baldengineer/State-Mode-Logic-Analyzer/images/state mode logic analyzer rev1 render.jpg

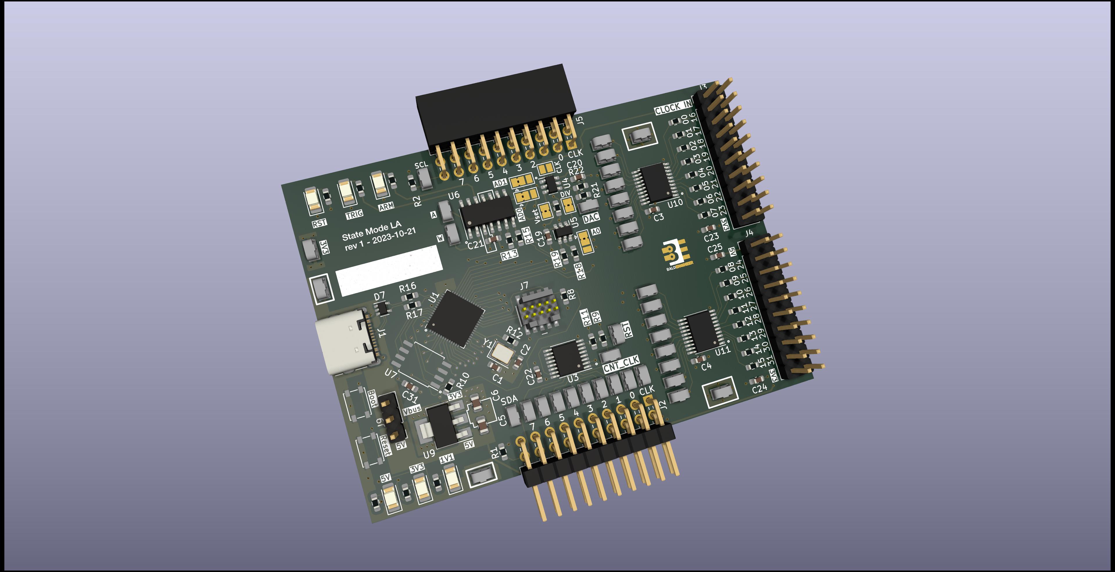
images/state mode logic analyzer rev1 render.jpg
