baldengineer/State-Mode-Logic-Analyzer/firmware/pico/README.md

This is some rough code to test on a Pi Pico. 

Eventually this will move to its own project, so don't be surprised if this doesn't build. 

:)
