baldengineer/State-Mode-Logic-Analyzer/kicad/rp2350/state mode logic analyzer rp2350.kicad_pcb

## KiCad design kicad/rp2350/state mode logic analyzer rp2350.kicad_pcb (2024-08-23)

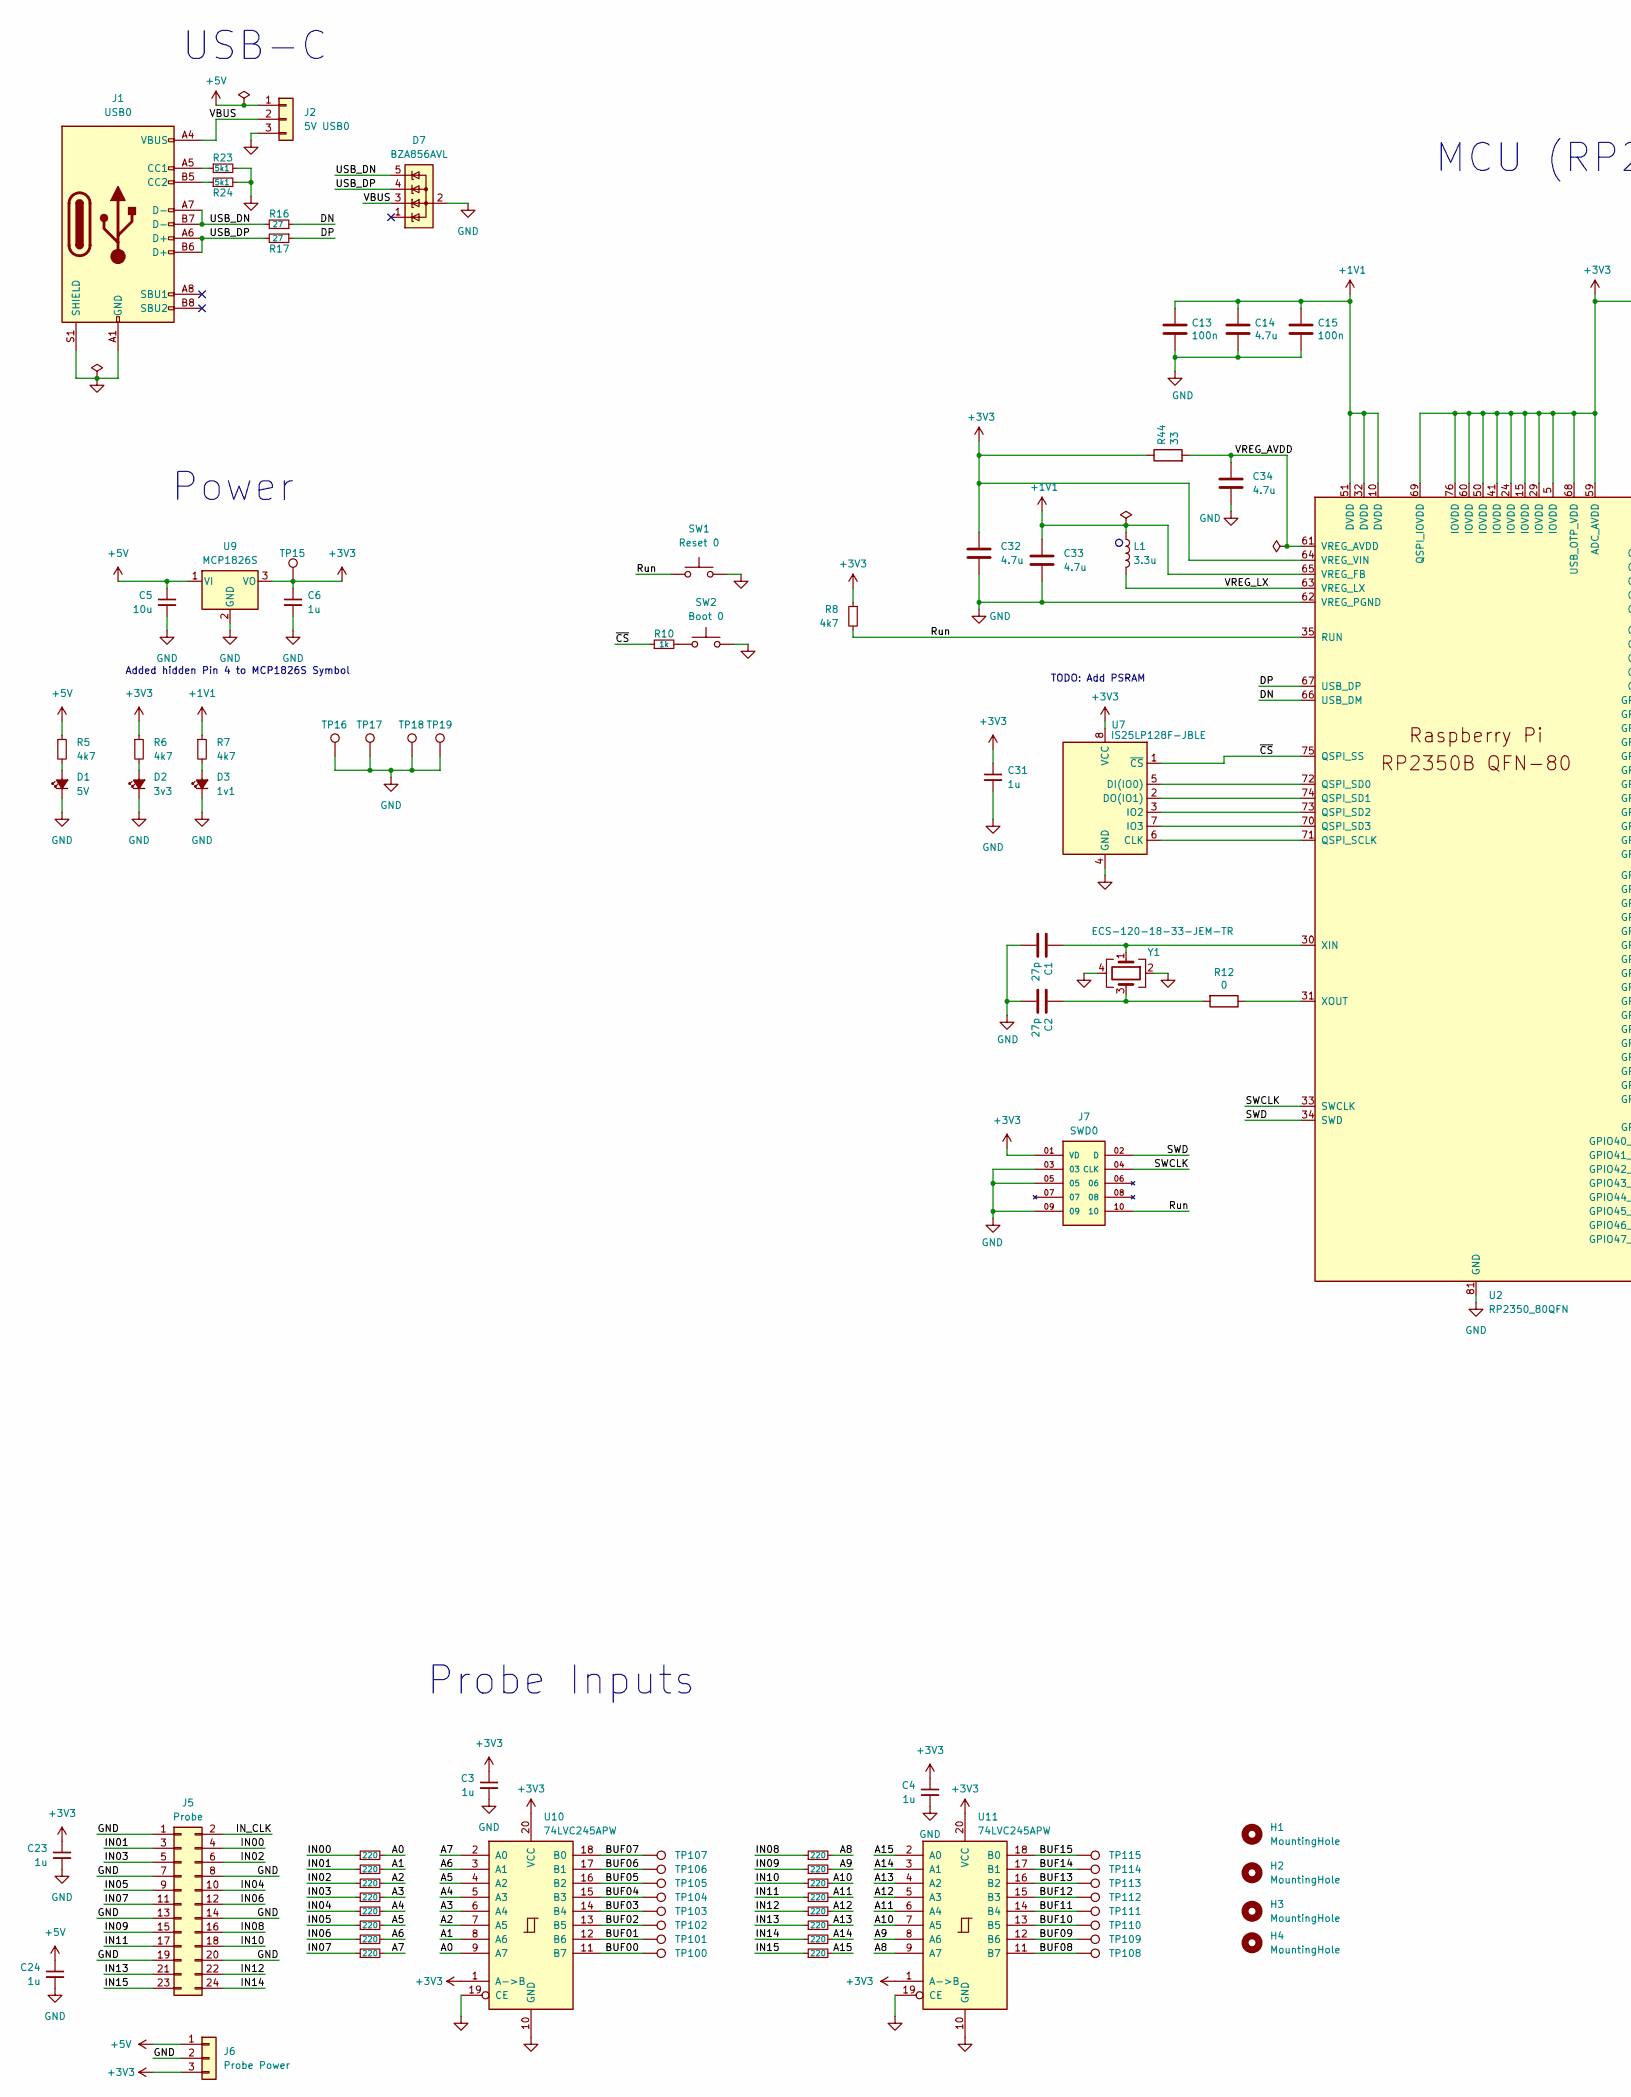
[picture p3: schematic state mode logic analyzer rp2350.kicad_sch, State Mode Logic Analyzer, part in row 1, column 1]

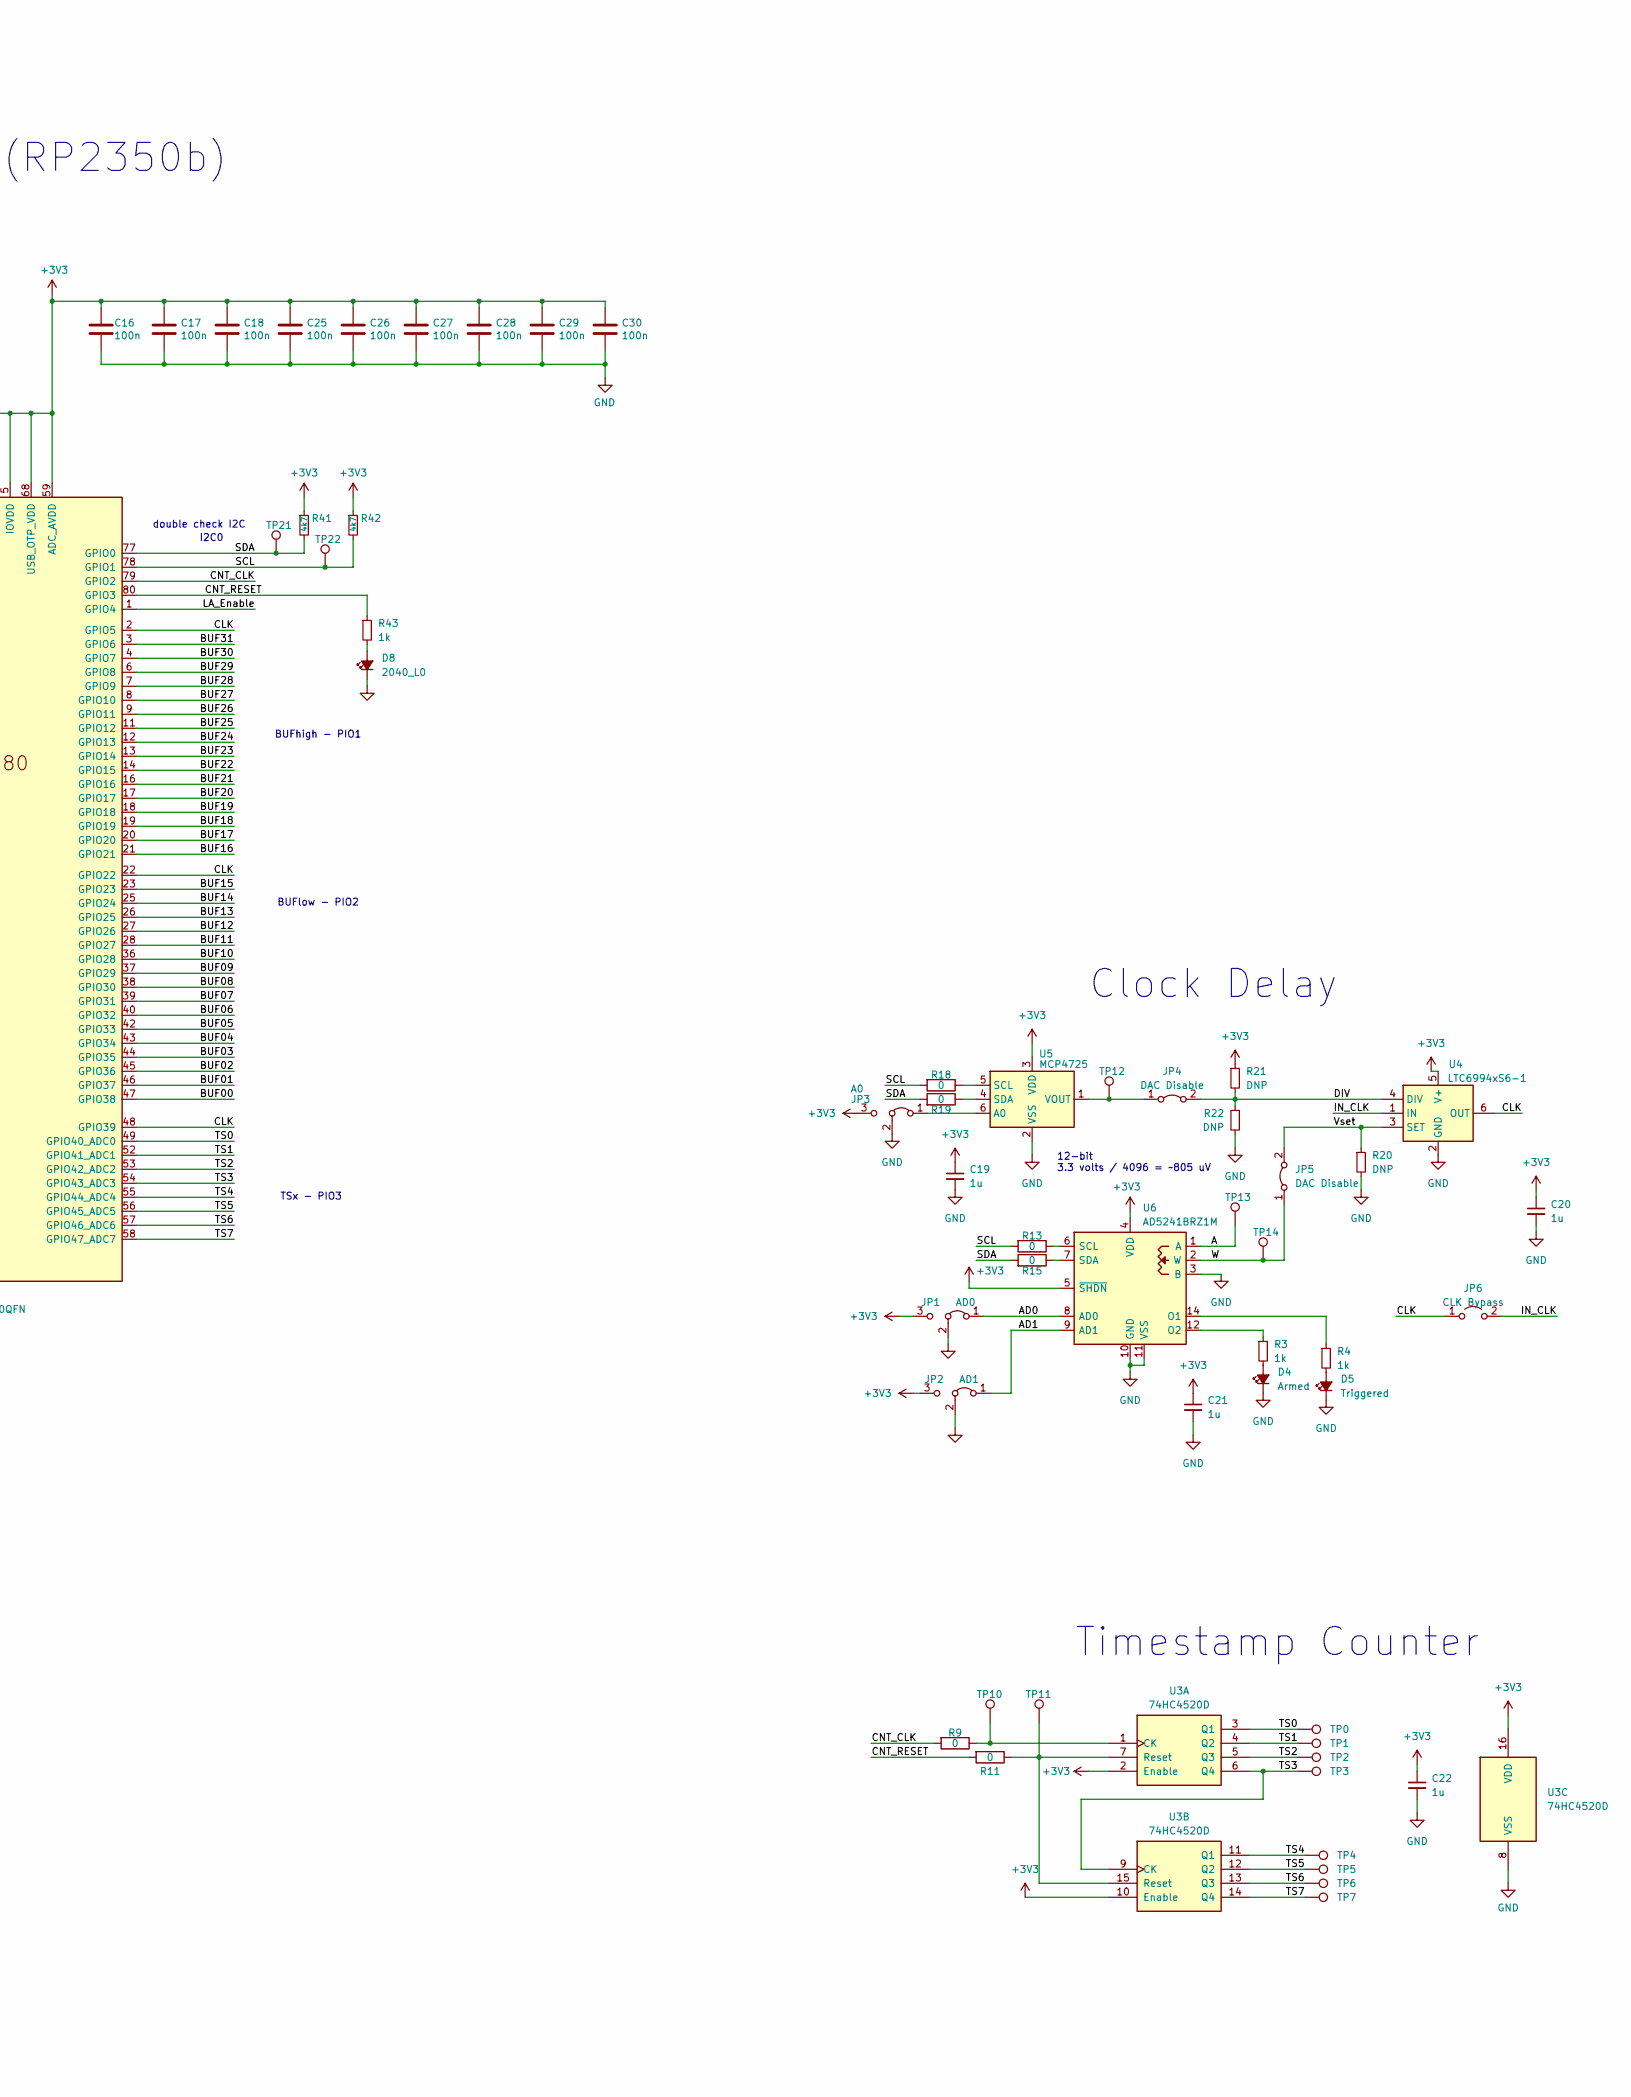
[picture p4: schematic state mode logic analyzer rp2350.kicad_sch, State Mode Logic Analyzer, part in row 1, column 2]

Parts:
C1, C2: 27p; C_0603_1608Metric
C3, C4, C19, C20, C21, C22, C23, C24, C31: 1u; C_0603_1608Metric_Pad1.08x0.95mm_HandSolder
C5: 10u; C_0805_2012Metric
C6: 1u; C_0805_2012Metric
C13, C15, C16, C17, C18, C25, C26, C27, C28, C29, C30: 100n; C_0402_1005Metric
C14, C34: 4.7u; C_0402_1005Metric
C32, C33: 4.7u; C_0402_1005Metric_small_pads
D1: 5V; LED_1206_3216Metric_Pad1.42x1.75mm_HandSolder
D2: 3v3; LED_1206_3216Metric_Pad1.42x1.75mm_HandSolder
D3: 1v1; LED_1206_3216Metric_Pad1.42x1.75mm_HandSolder
D4: Armed; LED_1206_3216Metric_Pad1.42x1.75mm_HandSolder
D5: Triggered; LED_1206_3216Metric_Pad1.42x1.75mm_HandSolder
D7: BZA856AVL; SOT-353_SC-70-5
D8: 2040_L0; LED_1206_3216Metric_Pad1.42x1.75mm_HandSolder
H1, H2, H3, H4: MountingHole; MountingHole_2.7mm
J1: USB0; USB_C_Receptacle_GCT_USB4105-xx-A_16P_TopMnt_Horizontal
J2: 5V USB0; PinHeader_1x03_P2.54mm_Vertical
J5: Probe; PinHeader_2x12_P2.54mm_Vertical
J6: Probe Power; PinHeader_1x03_P2.54mm_Vertical
J7: SWD0; SAMTEC_FTSH-105-XX-X-DV; PARTREV H
JP1: AD0; SolderJumper-3_P1.3mm_Bridged2Bar12_Pad1.0x1.5mm
JP2: AD1; SolderJumper-3_P1.3mm_Bridged2Bar12_Pad1.0x1.5mm
JP3: A0; SolderJumper-3_P1.3mm_Bridged2Bar12_Pad1.0x1.5mm
JP4, JP5: DAC Disable; SolderJumper-2_P1.3mm_Bridged2Bar_Pad1.0x1.5mm
JP6: CLK Bypass; SolderJumper-2_P1.3mm_Open_Pad1.0x1.5mm
L1: 3.3u; L_pol_2016
R3, R4, R10, R43: 1k; R_0603_1608Metric_Pad0.98x0.95mm_HandSolder
R5, R6, R7, R8, R41, R42: 4k7; R_0603_1608Metric_Pad0.98x0.95mm_HandSolder
R9, R11, R12, R13, R15, R18, R19: 0; R_0603_1608Metric_Pad0.98x0.95mm_HandSolder
R16, R17: 27; R_0603_1608Metric_Pad0.98x0.95mm_HandSolder
R20, R21, R22: DNP; R_0603_1608Metric_Pad0.98x0.95mm_HandSolder
R23, R24: 5k1; R_0603_1608Metric_Pad0.98x0.95mm_HandSolder
R25, R26, R27, R28, R29, R30, R31, R32, R33, R34, R35, R36, R37, R38, R39, R40: 220; R_0603_1608Metric
R44: 33; R_0402_1005Metric
SW1: Reset 0; SW_SPST_PTS810
SW2: Boot 0; SW_SPST_PTS810
TP0, TP1, TP2, TP3, TP4, TP5, TP6, TP7, TP10, TP11, TP12, TP13, TP14, TP15, TP16, TP17, TP18, TP19, TP21, TP22, TP100, TP101, TP102, TP103, TP104, TP105, TP106, TP107, TP108, TP109, TP110, TP111, TP112, TP113, TP114, TP115: TestPoint_Harwin; Harwin-S1751-46-Test-Point
U2: RP2350_80QFN; RP2350-QFN-80-1EP_10x10_P0.4mm_EP3.4x3.4mm_ThermalVias
U3: 74HC4520D; TSSOP-16_4.4x5mm_P0.65mm
U4: LTC6994xS6-1; TSOT-23-6
U5: MCP4725; SOT-23-6
U6: AD5241BRZ1M; SOIC-16_3.9x9.9mm_P1.27mm
U7: IS25LP128F-JBLE; SOIC-8_5.23x5.23mm_P1.27mm
U9: MCP1826S; SOT-223
U10, U11: 74LVC245APW; TSSOP-20_4.4x6.5mm_P0.65mm
Y1: ECS-120-18-33-JEM-TR; Crystal_SMD_3225-4Pin_3.2x2.5mm

Connections:
+1V1: C13.1, C14.1, C15.1, C33.1, L1.1, R7.1, U2.10 (DVDD), U2.32 (DVDD), U2.51 (DVDD), U2.65 (VREG_FB)
+3V3: C3.1, C4.1, C6.1, C16.1, C17.1, C18.1, C19.1, C20.1, C21.1, C22.1, C23.1, C25.1, C26.1, C27.1, C28.1, C29.1, C30.1, C31.1, C32.1, J6.3, J7.01 (VD), JP1.3 (B), JP2.3 (B), JP3.3 (B), R6.1, R8.1, R21.1, R41.1, R42.1, R44.1, TP15.1, U2.5 (IOVDD), U2.15 (IOVDD), U2.24 (IOVDD), U2.29 (IOVDD), U2.41 (IOVDD), U2.50 (IOVDD), U2.59 (ADC_AVDD), U2.60 (IOVDD), U2.64 (VREG_VIN), U2.68 (USB_OTP_VDD), U2.69 (QSPI_IOVDD), U2.76 (IOVDD), U3.2 (Enable), U3.10 (Enable), U3.16 (VDD), U4.5 (V+), U5.3 (VDD), U6.4 (VDD), U6.5 (~SHDN), U7.8 (VCC), U9.3 (VO), U10.1 (A->B), U10.20 (VCC), U11.1 (A->B), U11.20 (VCC)
+5V: C5.1, C24.1, J2.1, J6.1, R5.1, U9.1 (VI)
/A: TP13.1, U6.1 (A)
/A0: R25.2, U10.9 (A7)
/A1: R26.2, U10.8 (A6)
/A2: R27.2, U10.7 (A5)
/A3: R28.2, U10.6 (A4)
/A4: R29.2, U10.5 (A3)
/A5: R30.2, U10.4 (A2)
/A6: R31.2, U10.3 (A1)
/A7: R32.2, U10.2 (A0)
/A8: R33.2, U11.9 (A7)
/A9: R34.2, U11.8 (A6)
/A10: R35.2, U11.7 (A5)
/A11: R36.2, U11.6 (A4)
/A12: R37.2, U11.5 (A3)
/A13: R38.2, U11.4 (A2)
/A14: R39.2, U11.3 (A1)
/A15: R40.2, U11.2 (A0)
/AD0: JP1.1 (A), U6.8 (AD0)
/AD1: JP2.1 (A), U6.9 (AD1)
/BUF00: TP100.1, U2.47 (GPIO38), U10.11 (B7)
/BUF01: TP101.1, U2.46 (GPIO37), U10.12 (B6)
/BUF02: TP102.1, U2.45 (GPIO36), U10.13 (B5)
/BUF03: TP103.1, U2.44 (GPIO35), U10.14 (B4)
/BUF04: TP104.1, U2.43 (GPIO34), U10.15 (B3)
/BUF05: TP105.1, U2.42 (GPIO33), U10.16 (B2)
/BUF06: TP106.1, U2.40 (GPIO32), U10.17 (B1)
/BUF07: TP107.1, U2.39 (GPIO31), U10.18 (B0)
/BUF08: TP108.1, U2.38 (GPIO30), U11.11 (B7)
/BUF09: TP109.1, U2.37 (GPIO29), U11.12 (B6)
/BUF10: TP110.1, U2.36 (GPIO28), U11.13 (B5)
/BUF11: TP111.1, U2.28 (GPIO27), U11.14 (B4)
/BUF12: TP112.1, U2.27 (GPIO26), U11.15 (B3)
/BUF13: TP113.1, U2.26 (GPIO25), U11.16 (B2)
/BUF14: TP114.1, U2.25 (GPIO24), U11.17 (B1)
/BUF15: TP115.1, U2.23 (GPIO23), U11.18 (B0)
/BUF16: U2.21 (GPIO21)
/BUF17: U2.20 (GPIO20)
/BUF18: U2.19 (GPIO19)
/BUF19: U2.18 (GPIO18)
/BUF20: U2.17 (GPIO17)
/BUF21: U2.16 (GPIO16)
/BUF22: U2.14 (GPIO15)
/BUF23: U2.13 (GPIO14)
/BUF24: U2.12 (GPIO13)
/BUF25: U2.11 (GPIO12)
/BUF26: U2.9 (GPIO11)
/BUF27: U2.8 (GPIO10)
/BUF28: U2.7 (GPIO9)
/BUF29: U2.6 (GPIO8)
/BUF30: U2.4 (GPIO7)
/BUF31: U2.3 (GPIO6)
/CLK: JP6.1 (A), U2.2 (GPIO5), U2.22 (GPIO22), U2.48 (GPIO39), U4.6 (OUT)
/CNT_CLK: R9.2, U2.79 (GPIO2)
/CNT_RESET: R11.2, R43.1, U2.80 (GPIO3)
/DIV: JP4.2 (B), R21.2, R22.1, U4.4 (DIV)
/DN: R16.1, U2.66 (USB_DM)
/DP: R17.1, U2.67 (USB_DP)
/IN00: J5.4, R25.1
/IN01: J5.3, R26.1
/IN02: J5.6, R27.1
/IN03: J5.5, R28.1
/IN04: J5.10, R29.1
/IN05: J5.9, R30.1
/IN06: J5.12, R31.1
/IN07: J5.11, R32.1
/IN08: J5.16, R33.1
/IN09: J5.15, R34.1
/IN10: J5.18, R35.1
/IN11: J5.17, R36.1
/IN12: J5.22, R37.1
/IN13: J5.21, R38.1
/IN14: J5.24, R39.1
/IN15: J5.23, R40.1
/IN_CLK: J5.2, JP6.2 (B), U4.1 (IN)
/LA_Enable: U2.1 (GPIO4)
/Run: J7.10, R8.2, SW1.1, U2.35 (RUN)
/SCL: R13.2, R18.2, R42.2, TP22.1, U2.78 (GPIO1)
/SDA: R15.2, R19.2, R41.2, TP21.1, U2.77 (GPIO0)
/SWCLK: J7.04 (CLK), U2.33 (SWCLK)
/SWD: J7.02 (D), U2.34 (SWD)
/TS0: TP0.1, U2.49 (GPIO40_ADC0), U3.3 (Q1)
/TS1: TP1.1, U2.52 (GPIO41_ADC1), U3.4 (Q2)
/TS2: TP2.1, U2.53 (GPIO42_ADC2), U3.5 (Q3)
/TS3: TP3.1, U2.54 (GPIO43_ADC3), U3.6 (Q4), U3.9 (CK)
/TS4: TP4.1, U2.55 (GPIO44_ADC4), U3.11 (Q1)
/TS5: TP5.1, U2.56 (GPIO45_ADC5), U3.12 (Q2)
/TS6: TP6.1, U2.57 (GPIO46_ADC6), U3.13 (Q3)
/TS7: TP7.1, U2.58 (GPIO47_ADC7), U3.14 (Q4)
/USB_DN: D7.5 (K), J1.A7 (D-), J1.B7 (D-), R16.2
/USB_DP: D7.4 (K), J1.A6 (D+), J1.B6 (D+), R17.2
/VBUS: D7.3 (K), J1.A4 (VBUS), J1.A9 (VBUS), J1.B4 (VBUS), J1.B9 (VBUS), J2.2
/VREG_AVDD: C34.1, R44.2, U2.61 (VREG_AVDD)
/VREG_LX: L1.2, U2.63 (VREG_LX)
/Vset: JP5.2 (B), R20.1, U4.3 (SET)
/W: JP5.1 (A), TP14.1, U6.2 (W)
/~CS: R10.1, U2.75 (QSPI_SS), U7.1 (~CS)
GND: C1.2, C2.2, C3.2, C4.2, C5.2, C6.2, C13.2, C14.2, C15.2, C16.2, C17.2, C18.2, C19.2, C20.2, C21.2, C22.2, C23.2, C24.2, C25.2, C26.2, C27.2, C28.2, C29.2, C30.2, C31.2, C32.2, C33.2, C34.2, D1.1 (K), D2.1 (K), D3.1 (K), D4.1 (K), D5.1 (K), D7.2 (A), D8.1 (K), J1.A1 (GND), J1.A12 (GND), J1.B1 (GND), J1.B12 (GND), J1.S1 (SHIELD), J2.3, J5.1, J5.7, J5.8, J5.13, J5.14, J5.19, J5.20, J6.2, J7.03, J7.05, J7.09, JP1.2 (C), JP2.2 (C), JP3.2 (C), R20.2, R22.2, R23.2, R24.2, SW1.2, SW2.2, TP16.1, TP17.1, TP18.1, TP19.1, U2.62 (VREG_PGND), U2.81 (GND), U3.8 (VSS), U4.2 (GND), U5.2 (VSS), U6.3 (B), U6.10 (GND), U6.11 (VSS), U7.4 (GND), U9.2 (GND), U10.10 (GND), U10.19 (CE), U11.10 (GND), U11.19 (CE), Y1.2, Y1.4
unnamed: C2.1, R12.2, Y1.3
unnamed: D1.2 (A), R5.2
unnamed: D2.2 (A), R6.2
unnamed: D3.2 (A), R7.2
unnamed: D4.2 (A), R3.2
unnamed: D5.2 (A), R4.2
unnamed: D8.2 (A), R43.2
unnamed: J1.A5 (CC1), R23.1
unnamed: J1.B5 (CC2), R24.1
unnamed: JP3.1 (A), U5.6 (A0)
unnamed: JP4.1 (A), TP12.1, U5.1 (VOUT)
unnamed: R10.2, SW2.1
unnamed: U2.71 (QSPI_SCLK), U7.6 (CLK)
unnamed: U2.72 (QSPI_SD0), U7.5 (DI(IO0))
unnamed: U2.74 (QSPI_SD1), U7.2 (DO(IO1))
unnamed: U2.73 (QSPI_SD2), U7.3 (IO2)
unnamed: U2.70 (QSPI_SD3), U7.7 (IO3)
unnamed: C1.1, U2.30 (XIN), Y1.1
unnamed: R12.1, U2.31 (XOUT)
unnamed: R9.1, TP10.1, U3.1 (CK)
unnamed: R11.1, TP11.1, U3.7 (Reset), U3.15 (Reset)
unnamed: R18.1, U5.5 (SCL)
unnamed: R19.1, U5.4 (SDA)
unnamed: R4.1, U6.14 (O1)
unnamed: R3.1, U6.12 (O2)
unnamed: R13.1, U6.6 (SCL)
unnamed: R15.1, U6.7 (SDA)

Notes on the sheet:
BUFhigh - PIO1
Clock Delay
Timestamp Counter
Added hidden Pin 4 to MCP1826S Symbol
TODO: Add PSRAM
Power
BUFlow - PIO2
TSx - PIO3
USB-C
MCU (RP2350b)
12-bit 3.3 volts / 4096 = ~805 uV
Probe Inputs
I2C0
double check I2C

Board: 4 copper layers, 141 parts (2 on the bottom side), 110 nets, no tracks yet.

Other parts of the board:
svg2mod: G***; BE5v2
