baldengineer/State-Mode-Logic-Analyzer/firmware/pico/pico.c

#include <stdio.h>
#include "pico/stdlib.h"
#include "pico/binary_info.h"

#include "hardware/gpio.h"
#include "hardware/pio.h"
#include "hardware/dma.h"
#include "hardware/i2c.h"
#include "hardware/pwm.h"

#include "smla.pio.h"

#define CLK_IN 5
#define TS_CNTR_CLK 2
#define LED_PIN 3

void i2c_scan();

// PIO 1 of ?
PIO pio;
uint pio_offset;
uint pio_sm;
uint la_dma_chan=10;

// Buffer for data capture
#define SAMPLE_COUNT 4096
uint32_t cap_buf[SAMPLE_COUNT]; // 128 kilobytes, i think?

// shortcut for setting up output pins (there isn't a SDK call for this?)
void out_init(uint8_t pin, bool state) {
    gpio_init(pin);
    gpio_set_dir(pin, GPIO_OUT);
    gpio_put(pin, state);
}

// incoming data is only 24 bits wide, but I think
// I need to align things to a 32-bit boundry?
void fill_buffer(uint32_t *cap_buf) {
    for (uint16_t x=0; x<SAMPLE_COUNT; x++) {
        cap_buf[x] = 0xFFFF;
    }
}

// borrowed from mega's vga2040
void print_hex_buf(const uint32_t *buf, uint word_count, uint line_count) {
    printf("---[START]---\n");
    for (int x=0; x < (word_count * line_count); x++) {   // 
        if (x % 10 == 0)
            printf("\n");
        uint32_t current_word = buf[x];
        printf("%08x", current_word);
    }
    printf("\n---[END]---\n");

}

void print_capture_buf(const uint32_t *buf, uint word_count, uint offset) {
   // printf("Captured: Hex, Binary, RGBx[4 Words, right to left]\n");
    for (int x=0; x < word_count; x++) {
       // printf("%d:%08x, b%b\n", x, buf[x], buf[x]); // lol, %b works
       uint32_t current_buf = buf[x+(word_count*offset)];
        printf("%d: 0x%02x\n", x+(word_count*offset), current_buf); // lol, %b works

        // for (int j=0; j<8; j++) {
        //     uint offset = 4 * j;
        //     printf((current_buf & (0x1<<0+(offset))) ? "1" : "0");
        //     printf((current_buf & (0x1<<1+(offset))) ? "1" : "0");
        //     printf((current_buf & (0x1<<2+(offset))) ? "1" : "0");
        //     printf((current_buf & (0x1<<3+(offset))) ? "1" : "0");
        //     printf((j!=7) ? ", " : "");
        // } 
        // printf("\n");
    }
   // printf("\n");
}


void smla_pio_setup() {
    pio = pio0;
    pio_offset = pio_add_program(pio, &SMLA_program);

    pio_sm = pio_claim_unused_sm(pio, true);
    pio_sm_config c = SMLA_program_get_default_config(pio_offset);
    pio_sm_set_enabled(pio, pio_sm, false);

    pio_gpio_init(pio, CLK_IN);

    sm_config_set_in_pins(&c, 8);
    pio_sm_set_consecutive_pindirs(pio, pio_sm, 8, 8, GPIO_IN);
    sm_config_set_clkdiv(&c, 1); 

    // From C SDK PDF:
    // sm_config_set_in_shift sets the shift direction to rightward, enables autopush, and sets the autopush threshold to 32.
    // The state machine keeps an eye on the total amount of data shifted into the ISR, and on the in which reaches or
    // breaches a total shift count of 24 (or whatever number you have configured), the ISR contents, along with the new data
    // from the in. goes straight to the RX FIFO. The ISR is cleared to zero in the same operation.
    sm_config_set_in_shift(&c, false, true, 8); // i've setup 8 bits to make this boundry clean, i think
    //sm_config_set_fifo_join(&c, PIO_FIFO_JOIN_NONE); // PIO_FIFO_JOIN_NONE, _RX, _TX
    
    pio_sm_init(pio, pio_sm, pio_offset, &c);
}

void smla_pio_stop() {
    pio_sm_set_enabled(pio, pio_sm, false);
    pio_sm_clear_fifos(pio, pio_sm);  
}

void smla_pio_run() {
    pio_sm_set_enabled(pio, pio_sm, false);
    pio_sm_restart(pio, pio_sm);
    pio_sm_clear_fifos(pio, pio_sm);  


    // ------------------
   // la_dma_chan = 10;// dma_claim_unused_channel(false);
    dma_channel_config c = dma_channel_get_default_config(la_dma_chan);
    channel_config_set_read_increment(&c, false);
    channel_config_set_write_increment(&c, true);
	//channel_config_set_bswap(&c,true);
    channel_config_set_dreq(&c, pio_get_dreq(pio, pio_sm, false));

    dma_channel_configure(
        la_dma_chan,            // dma channel
        &c,                     // configuration
        cap_buf,                // Destination pointer
        &pio->rxf[pio_sm],      // Source pointer
        SAMPLE_COUNT,           // Number of transfers
        true                    // Start immediately
    );
    //------------------

    // will the real PIO reset, please stand up.
   //    
    pio_sm_exec(pio, pio_sm, pio_encode_jmp(SMLA_offset_start)); // why is this locking up the PIO now?
    pio_sm_set_enabled(pio, pio_sm, true);
    // Load our configraution, and jump to program start
    // pio_sm_init(pio, pio_sm, pio_offset, &c);

    // set the state machine running
    // pio_sm_set_enabled(pio, pio_sm, true);
}


void setup_pwm(uint16_t pwm_wrap, uint16_t pwm_level) {
    gpio_set_function(TS_CNTR_CLK, GPIO_FUNC_PWM);

    uint slice_num = pwm_gpio_to_slice_num(TS_CNTR_CLK);
    printf("GPIO %d has PWM slice %d", TS_CNTR_CLK, slice_num);
    pwm_set_wrap(slice_num, 2); // 0 to 4 inclusive
    pwm_config config = pwm_get_default_config();
    // Set divider, reduces counter clock to sysclock/this value
    //pwm_config_set_clkdiv(&config, 4.f);
    // Load the configuration into our PWM slice, and set it running.
    pwm_init(slice_num, &config, true);

    pwm_set_gpio_level(TS_CNTR_CLK, pwm_level);
    pwm_set_wrap(pwm_gpio_to_slice_num(TS_CNTR_CLK), pwm_wrap);
}

void counter_pwm_state(bool state) {
    pwm_set_enabled(pwm_gpio_to_slice_num(TS_CNTR_CLK), state);
}

void run_the_analyzer() {
    uint64_t start;
    uint64_t end;
    int difference;

    puts("Running State Machine");
    start = time_us_64();
    smla_pio_run();
    dma_channel_wait_for_finish_blocking(la_dma_chan);
    end = time_us_64();
    puts("Disabling State Machine");
    smla_pio_stop();
    print_capture_buf((uint32_t*)cap_buf,32,0);
    difference = end-start;
    printf("Analyzer capture took %d us\n", difference);
}

void scan_buffer() {
    uint64_t start;
    uint64_t end;
    int difference;


    uint16_t matched_sample = 0;
    start = time_us_64();
    for (uint16_t x=0; x < SAMPLE_COUNT; x++) {
        if (cap_buf[x] == 0x0000) {
            matched_sample = x;
        }
    }
    end = time_us_64();
    difference = end - start;
    printf("Scan took %d us and matched on sample %d\n", difference, matched_sample);
}

inline void check_for_usb_input() {
    //     if (stdio_usb_connected()) {
    //     // do we need to dump a buffer?
    //     uint8_t incoming_char = getchar_timeout_us(0);
            // if ((incoming_char == '!'))
            //     print_hex_buf((uint32_t*)Box, WIDTHWORDS, LINE_COUNT);
            // if ((incoming_char == '@'))
            //     print_capture_buf((uint32_t*)Box, WIDTHWORDS, 0);
            // if ((incoming_char == '#'))
            //     print_capture_buf((uint32_t*)Box, WIDTHWORDS, (HEIGHT-1)); 
            // if ((incoming_char == '?'))
            //     printf("\nHi\n");
    // }
    if (stdio_usb_connected()) {
        uint8_t incoming_char = getchar_timeout_us(0);
        if ((incoming_char == '!')) {  
            run_the_analyzer();
        }
        if ((incoming_char == '@')) {
            uint pwm_reg = (*(uint *)(PWM_BASE+0x14));
            if (pwm_reg & PWM_CH1_CSR_EN_BITS ) {
                puts("Disabling counter clock");
                counter_pwm_state(false);
            } else {
                puts("Enabling counter clock");
                counter_pwm_state(true);
            }
        }
        if ((incoming_char == '$')) {
            scan_buffer();
        }
        if ((incoming_char == '^')) {
            i2c_scan();
        }
    }
}

void setup() {
    //setup_default_uart();
    stdio_usb_init();

    smla_pio_setup();

    out_init(LED_PIN, true);
    
    // this won't work because you can only use 21, 23, 24, 25
    //clock_gpio_init(TS_CNTR_CLK, CLOCKS_CLK_GPOUT0_CTRL_AUXSRC_VALUE_CLK_SYS, 10);

    setup_pwm(11,5);

    printf("Hello, world!\n");
}
int main() {
    setup();
    //fill_buffer(cap_buf);
    volatile uint32_t blink_interval = 500000;
    for(;;) {
        static uint32_t previous_ticks=0;
        static bool led_state=true;

        if (time_us_32()-previous_ticks >= blink_interval) {
            previous_ticks = time_us_32();
            led_state = !led_state;
            gpio_put(LED_PIN, led_state);
            //printf("pin 2: %d\n",gpio_get(2));
        }
        check_for_usb_input();
    }
    return 0;
}

// I2C reserves some addresses for special purposes. We exclude these from the scan.
// These are any addresses of the form 000 0xxx or 111 1xxx
bool reserved_addr(uint8_t addr) {
    return (addr & 0x78) == 0 || (addr & 0x78) == 0x78;
}

#define SDA_PIN 0
#define SCL_PIN 1


void i2c_scan() {
    // This example will use I2C0 on the default SDA and SCL pins (GP4, GP5 on a Pico)
    i2c_init(i2c_default, 100 * 1000);
    gpio_set_function(SDA_PIN, GPIO_FUNC_I2C);
    gpio_set_function(SCL_PIN, GPIO_FUNC_I2C);
    // gpio_pull_up(SDA_PIN);
    // gpio_pull_up(SCL_PIN);
    // Make the I2C pins available to picotool
    bi_decl(bi_2pins_with_func(SDA_PIN, SCL_PIN, GPIO_FUNC_I2C));

    printf("\nI2C Bus Scan\n");
    printf("   0  1  2  3  4  5  6  7  8  9  A  B  C  D  E  F\n");

    for (int addr = 0; addr < (1 << 7); ++addr) {
        if (addr % 16 == 0) {
            printf("%02x ", addr);
        }

        // Perform a 1-byte dummy read from the probe address. If a slave
        // acknowledges this address, the function returns the number of bytes
        // transferred. If the address byte is ignored, the function returns
        // -1.

        // Skip over any reserved addresses.
        int ret;
        uint8_t rxdata;
        if (reserved_addr(addr))
            ret = PICO_ERROR_GENERIC;
        else
            ret = i2c_read_blocking(i2c_default, addr, &rxdata, 1, false);

        printf(ret < 0 ? "." : "@");
        printf(addr % 16 == 15 ? "\n" : "  ");
    }
    printf("Done.\n");
}
