baldengineer/State-Mode-Logic-Analyzer/(commit log)

2023-10-20 initial schematic layout before ERC
    [state mode logic analyzer.kicad_sch]
2023-10-20 switched to usb-c
    [state mode logic analyzer.kicad_sch]
2023-10-20 passed erc for first schem ver
    [state mode logic analyzer.kicad_sch]
2023-10-20 initial pcb plop
    [state mode logic analyzer.kicad_pcb]
2023-10-20 saving current state to try a different design
    [state mode logic analyzer.kicad_pcb]
2023-10-21 floor planning ongoing
    [state mode logic analyzer.kicad_pcb, state mode logic analyzer.kicad_sch]
2023-10-21 going to re-order all the IOs
    [state mode logic analyzer.kicad_pcb, state mode logic analyzer.kicad_sch]
2023-10-21 passed drc and started silk clean up
    [state mode logic analyzer.kicad_pcb, state mode logic analyzer.kicad_sch]
2023-10-22 rev1 before verification
    [state mode logic analyzer.kicad_pcb, state mode logic analyzer.kicad_sch]
2023-10-22 rneed to review again
    [state mode logic analyzer.kicad_pcb, state mode logic analyzer.kicad_sch]
2023-10-22 Deocrated schematic
    [state mode logic analyzer.kicad_pcb, state mode logic analyzer.kicad_sch]
2023-10-22 gerbers plotted for fab
    [state mode logic analyzer.kicad_pcb]
2023-10-22 added distributor part numbers
    [state mode logic analyzer.kicad_sch]
2023-10-22 fixed J desgs and swapped prog header part num
    [state mode logic analyzer.kicad_pcb, state mode logic analyzer.kicad_sch]
2023-11-10 initial pico test code
2023-11-10 setup PIO, DMA, and Serial. Untested
2023-11-15 pico sampling 8 bits seemingly correct
    [pico.c]
2023-11-15 Fixed encode_jmp bug with origin addr
    [pico.c]
2023-11-16 changed clk_in to match PCB
2023-11-18 pwm clock gen
2023-11-20 i2c scan from examples and pwm code on final board
2024-08-22 starting over
    [state mode logic analyzer.kicad_pcb]
2024-08-22 moving stuff around
    [state mode logic analyzer-B_Cu.gbr, state mode logic analyzer-B_Mask.gbr, state mode logic analyzer-B_Paste.gbr, state mode logic analyzer-B_Silkscreen.gbr, state mode logic analyzer-Edge_Cuts.gbr, state mode logic analyzer-F_Cu.gbr, state mode logic analyzer-F_Mask.gbr, state mode logic analyzer-F_Paste.gbr]
2024-08-23 fixing ERC errors
    [state mode logic analyzer rp2350.kicad_pcb, state mode logic analyzer rp2350.kicad_sch]
2024-08-23 end of stream commit
    [state mode logic analyzer rp2350.kicad_pcb, state mode logic analyzer rp2350.kicad_sch]
2024-08-31 removed clock delay and timestamp counter since it can be done in pio.
    [state mode logic analyzer rp2350.kicad_sch]
